Michae1Park/Batteryless_Implant/README.md

# SeniorDesign
Our Senior Design Project to build a medical implant for Rats

Contributor:
Michael Park,
Corey Cormier,
Albert Marzullo,
Makeila Sorensen,
Anish Vaghasia,
Thomas Ermis
