Michae1Park/Batteryless_Implant/Papers/Systems_Design_backup.odt

1.0 INTRODUCTION

This system design report details the design and implementation of an embedded implant system for lab animals in a research environment. This system will aid in research environments that use lab animals for testing purposes. In normal lab environments it can be difficult for researchers to take precise multiple measurements of lab animals for data acquisition purposes. Therefore a system that will allow the researcher to make quick, easy measurements from lab animals and efficiently process the data would provide a great benefit to many research companies. This design was created after careful analysis of client needs, thorough research, and consideration of final deliverables. The proposed design calls for a three subsystem approach made of an implant, a base station, and a web application. The implant will be surgically implanted in the rat and will collect the data. The implant will be wirelessly powered and communicated with by the base station. The base station will in turn collect the data and wirelessly transfer the data to a web app that will collect and display information to the user. Our design will meet the specific needs of our client as defined below while also leaving room for flexibility for future applications.

In order to fully summarize the proposed design, the paper will first outline the problem and the needs of the client. Then the necessary performance

2.0 DESIGN PROJECT BACKGROUND

2.1 Problem Definition

The methods that scientists currently use to collect data from laboratory rats are highly inefficient. Each time a scientist needs to analyze data from a single rat, he or she has to repeatedly collect blood or urine samples, which is time-consuming and expensive. Therefore, Dr. Valvano needs a data acquisition system that will allow scientists to monitor the data more efficiently and at a lower cost. He requires that we reconstruct and improve upon the design of a three-part system that he and a graduate student, Andrew Wang, have partially implemented. The first component needs to be batteryless and wireless implant that will be embedded into a rat and collect data from sensors. The second component needs to be a base station that will use induction coils to wirelessly power and communicate with the implant. The third component needs to be a user interface that will receive commands from a user, communicate with the base station, and display the collected data. The idea is that a scientist would send a command from the user interface to the base station to power the implant. From there, the implant would collect data and communicate that data back to the base station and to the user interface for the scientist to monitor and analyze.

2.2 Needs Analysis

As the primary stakeholder of our project, Dr. Valvano needs a data acquisition system that allows scientists to monitor data from laboratory rats more efficiently and at a lower cost. In order for our team to design such a system, Dr.Valvano has provided us with a set of requirements.

The following list outlines Dr. Valvano’s needs for the data acquisition system.

- The system needs to consist of an implant, base station, and web application in order to compartmentalize functionality.
- The implant needs to have a long lifespan so that it can be embedded in a rat and not have to be consistently replaced.
- The implant needs to be small enough so that it can be embedded into a rat without affecting how the rat functions.
- The implant needs to be sterile and biocompatible so that it can be embedded into a rat without causing the rat any harm.
- Because of the environmental constraints, the implant needs to be wireless, cannot have a battery, and cannot have bluetooth or wifi modules.
- The base station needs to use induction coils to wirelessly power the implant since the implant needs to be wireless and cannot have a battery.
- The implant needs to flash an LED on and off so that the users know when the implant is powered.
- The implant needs to accurately collect temperature and acceleration data so that the users can monitor and analyze the temperature and acceleration of a rat.
- The implant and the base station need to use induction coils to wirelessly communicate with each other in order to send and receive commands and data.
- The base station and the web application need to wirelessly communicate with each other in order to send and receive commands and data.
- The web application needs to be accessible and scalable in order to maximize user population.
- The web application needs to accept input from a user so that the user can request data from the implant.
- The web application needs to display the data from the implant real-time so that the users can easily monitor and analyze it.
- The web application needs to accurately store the data in a database so that the users can view a historical record of the data.
- The system needs to be secure in order to protect any proprietary information and confidential data.

Design Functionality

2.3 Performance and Environmental Specifications

In order for our design to satisfy Dr. Valvano’s needs, it must function accurately and efficiently independent of varying environmental conditions. The performance specifications optimize the lifespan of the implant, bandwidth between the implant and base station, scalability and security of the web application, and the response time of the entire system. The environment specifications account for the implant having to operate within a rat, the base station requiring a power supply and internet connection, and the web application needing to function on multiple platforms and browsers. Achieving these specifications will allow our system to operate accurately and efficiently under a variety of external settings.

2.3.1 Performance Specifications

In order to be used as intended, the system must adhere to specific performance requirements. First, the implant must be able to last within the rat for an extended period of time. Second, the induction coils of the base station must deliver enough power to the implant to be able to drive microprocessor and the sensors on the implant. The exact power required will depend on the sensors we use to take the measurements. Third, the implant will need to be able to take different measurements and communicate them to the base station in an appropriate amount of time. Fourth, these measurements must be accurate to a certain degree to ensure the usefulness of the data. Finally, the base station and implant must communicate in accordance to applicable communication standards. Table 5 describes the performance specifications in more detail.

Table X. Performance Specifications

Subsystem | Name | Description | Specification
Implant | Minimum Lifespan | Minimum length of time that the implant must operate for from the time of implantation | 6 months
Implant and Base Station | Minimum Bandwidth | Minimum speed at which the implant and base station must transfer bits of data to and from each other | 1 Hz
Web Application | Scalability | Level of scalability offered by the web application | Horizontal, Vertical
Web Application | Security | Level of security protecting the web application | Authentication, Authorization, Integrity, Encryption, Auditing
System | Maximum Response Time | Maximum length of time that the system must respond to the user within | 1 minute

2.3.2 Environmental Specifications

The system is intended to be used in a laboratory or some other controlled environment, so there are no harsh or unusual conditions that the base station and user interface must operate under. However, because the implant will be embedded in a live rat, there are environmental requirements that our implant must meet. First, the implant must be small enough to fit inside a rat. Second, the device must be able to function correctly before implantation, and therefore at room temperature. Third, it must operate inside the rat, despite fluctuations of the internal temperature of the rat, which can range anywhere from 35.9° to 39.4° Celsius [10]. Fourth, the implant must be unaffected by any internal fluid surrounding it inside of the rat. Finally, the device must be sterile and biocompatible. This means the implant must be free from bacteria or other living microorganisms and the device must not be harmful to living tissue. This will ensure that the implant does not negatively impact the rat’s health. Table 6 describes the environment specifications in more detail.

Table X. Environmental Specifications

Subsystem | Name | Description | Specification
Implant | Maximum Footprint | Maximum area of the implant | 25 cm2
Implant | Sterility | Minimum sterility assurance level for the implant | SAL of 10-6 [X]
Implant | Biocompatibility | Minimum standard of biocompatibility for the implant | ISO 10993 [X]
Implant | Temperature | Range of temperature for the implant to operate in | 15° to 45° C
Base Station | Power | Power source for the base station | Access to power outlets
Base Station and Web Application | Internet | Internet connection for the base station and web application | Access to secure wifi
Web Application | Platforms | Minimum platforms the web application needs to be accessed on | Windows 7, Mac OS X, Linux
Web Application | Browsers | Minimum browsers the web application needs to be accessed on | Chrome 49, FireFox 45, Safari 9, Opera 35, Microsoft Edge 24, Internet Explorer 10

2.4 Deliverables

There are several deliverables that we will provide by the end of the Fall 2016 semester. These project deliverables consist of a prototype of our data acquisition system and the associated documentation. The prototype will be a three-part system consisting of the implant, the base station, and the user interface. The implant will be small and batteryless, and will collect temperature and acceleration data from within a mock rat. The base station will wirelessly power and communicate with the implant and the user interface will display the collected data. The documentation will include both stakeholder and user documentation. The stakeholder documentation will describe our research and our design, and include code, schematic diagrams, circuit board layouts, and design documentation. The user documentation will describe the installation, operation, and maintenance of the system.

Relevant Standards

3.0 SYSTEM DESIGN

The final prototype of the data acquisition system will consist of three subsystems with inputs and outputs to and from the user. The three subsystems consist of an implant, a base station, and a user interface.

The user interface will allow the user to control the system via commands to the base station. These commands will allow the user to initiate data acquisition, view the requested data, and view a history of past data collected.

The base station’s main function is to wirelessly power and communicate with the implant. When powered, the base station will power the implant through a pair of coupled induction coils. ~~drive an alternating current through a transmission coil located on top of the rat’s cage in order to create an alternating magnetic field through the cage. This alternating magnetic field will then create an alternating current on a receiver coil on the implant located inside the rat.~~ ~~Modulation of this magnetic field~~ These coils will also be used to send commands from the base station to the implant.

The implant will then measure the temperature and acceleration of the rat. Next, the implant will relay temperature and acceleration measurements from the rat and the implant’s ID back to the base station through a communication antenna on the implant. This data will then be transmitted to the user through the user interface.

Figure X. System Block Diagram

3.1 Implant Design (too much detail? particularly in spec paragraph)

The implant will collect biomedical data from a laboratory rat in which it is implanted and transmit the data to the base station as shown in Figure 1. As discussed before, the implant needs to collect temperature and acceleration data, to wirelessly communicate with the base station, and be wirelessly powered, sterile, biocompatible and small enough to be implanted in a laboratory rat. Thus, an induction coil, a temperature sensor, and an accelerometer sensor is required. Details of the specifications of the implant will be discussed in the following paragraph.

Table X. Implant Input Specifications

From | Name | Description | Specification
Base Station | Wireless Power | Amount of power transferred within a certain distance | Range 0 to 200 mW 0 to 18 cm Accuracy ± 0.00 mW ± 0.01 cm
Base Station | Data Command | Command to acquire data | See Table X. Data Command Specifications
Sensor | Temperature | Temperature measurement | Range 15° to 45° C Accuracy ± 0.01° C
Sensor | Acceleration | Acceleration measurement | Range ± 2 g Accuracy 0.01 g

Table X. Implant Output Specifications

To | Name | Description | Specification
Base Station | Data | Results from the data acquisition | See Table X. Data Specifications

  1. Implementation
    1. RF430
    2. LIS3DH (accelerometer)

-> state why we picked these components

  2. Pseudo Conclusion
    1. Tie back to how our implementation meets the requirements

3.2 Base Station Design

The base station will primarily serve as a power source for the implant and a “middleman” that connects the implant and the web application. The base station will receive and transmit the data sent from the implant to the web application as shown in Figure 1. As mentioned before, in order for the base station to meet our needs to wirelessly power and communicate with the implant, use of induction coil and access to the Internet. Details of the input and output specifications to meet the requirements will be discussed in the following paragraph.

The base station requires inputs from three different sources: user inputs, web application inputs, and an implant input. These user inputs include power, Internet connection, power command, data command, and data as presented in the table X below. The user inputs include power and Internet connection. First user input is power for the base station which should provide 3.3V and 1A since all of our components require 3.3V voltage and maximum of 1A current in entirety. Second user input is a secure Wifi connection as the base station needs to send and receive commands and data. The inputs from the web application include power command and data command. The power command needs to turn the base station on from standby state, and the data command needs to send the base station to start and stop data collection, which in turn will be sent to the implant. Both commands will simply have one bit binary data to represent, on/standby and start/stop data collection. The input from the implant is the data collected from the implant. The data will be represented in 16 digit sequence of numbers. In the following section, implementation of our base station will be described to address all the specifications addressed.

Table X. Base Station Inputs

From | Name | Description | Specification
User | Power | Power source for the base station | Value 3.3 V 1 A Accuracy ± 0 V ± 0 A
User | Internet | Internet connection for the base station | Secure wifi
Web Application | Power Command | Command to turn on the base station | See Table X. Power Command Specifications
Web Application | Data Command | Command to acquire data | See Table X. Data Command Specifications
Implant | Data | Results from the data acquisition | See Table X. Data Specifications

Table X. Base Station Outputs

To | Name | Description | Specification
Implant | Wireless Power | Amount of power transferred within a certain distance | Range 0 to 200 mW 0 to 18 cm Accuracy ± 0 mW ± 0.01 cm
Implant | Data Command | Command to acquire data | See Table X. Data Command Specifications
Web Application | Data | Results from the data acquisition | See Table X. Data Specifications

The base station will consist of a coil, an NFC/RFID transceiver, a microcontroller, and a Wifi module to control the subsystem, power and communicate with the implant, and transit data to the web app respectively. TRF7970A will be used for the NFC/RFID transceiver because it can directly control the coil to power the implant and receive the data from the implant. MSP430 will be used for the microcontroller due to its low power nature and its compatibility with TRF7970A. The ESP8266 will be used for the Wifi module because it is small, reliable, and cheap. The coil will be interfaced to the TRF7970A which in turn will be interfaced to the MSP430, and separately, ESP8266 will be interfaced to the MSP430. The TRF7970A will communicate with the MSP430 to transmit data using serial synchronous interface (SSI). The ESP8266 will use universal asynchronous receiver/transmitter (UART) to communicate with the MSP430. We will use a wall power and an AC-DC power converter to power the base station. The AC-DC power converter will output 3.3V and 1A, and TRF7970A, MSP430, and ESP8266 will be connected respectively. As described, our implementation of the base station using the components TRF7970A, ESP8266, and MSP430 will fulfill the requirements to wirelessly power and communicate with the implant and to transmit data received from the implant all the way to the web application.

3.3 Web Application Design

The third subsystem of the Data Acquisition System is a web application. In order for the web application to operate as efficiently as possible, it needs to be accessible and scalable. In addition, it needs to receive commands from the user, send commands to and receive data from the base station, display the data back to the user, and store the data in a database. Please refer to Tables X and X below for a detailed description of the web application’s inputs and outputs. Finally, because the data handled by the web application might be confidential, it is important that the web application is secure.

Table X. Web Application Input Specifications

From | Input | Description | Specification
User | Authentication | Credentials to access to the web application | See Table X. Authentication Specifications
User | Power Command | Command to turn on the base station | See Table X. Power Command Specifications
User | Data Command | Command to acquire data | See Table X. Data Command Specifications
Base Station | Data | Results from the data acquisition | See Table X. Data Specifications

Table X. Web Application Output Specifications

To | Output | Description | Specification
Base Station | Power Command | Command to turn on the base station | See Table X. Power Command Specifications
Base Station | Data Command | Command to acquire data | See Table X. Data Command Specifications
User | Data | Results from the data acquisition | See Table X. Data Specifications

The web application will be built using IBM Bluemix, a cloud platform for developing accessible and scalable web and mobile applications. In order to secure the web application, we will use the Single Sign On service that is provided by IBM Bluemix. This service requires users who are attempting to access the web application to authenticate themselves. As depicted in Figure X below, we will use the IBM Watson Internet of Things Platform (WIoT) service in order to interface the web application with the base station. As long as both the base station and the web application are connected to the internet, they can use the WIoT service to communicate with each other. In other words, the web application will be able to send commands to the base station and the base station will be able to send data back to the web application. Upon receiving data, the web application will display the data on a web page and store the data in a database. In order to store the data in a database, we will use the Cloudant NoSQL Database service, which is also provided by IBM Bluemix.

Figure X. Web Application Block Diagram

<FIGURE>

4.0 USER INTERFACE DESIGN

The user interface for the Data Acquisition System consists of a web page on the web application and an LED on the implant. Initially, the implant will be off and the base station will be on standby. Through the web page, the user will send a command to the base station to switch it from standby mode to on. Once the base station is on, the user will send a command to the base station to acquire data from the implant. From there, the base station will power the implant. In order to indicate the the implant is on, an LED on the implant will flash on and off. Now that the implant has power, the base station will send a command to the implant to acquire data from the sensors. Once the implant collects temperature and acceleration data, the implant will send the data back to the base station. From there, the base station will send the data back to the web application. Once the web application receives the data, it will store the data into a database as well as display the data on a web page for the user to monitor and analyze.

5.0 RISK REDUCTION

We have taken steps to reduce the risks that would prevent us from finishing the project on time. Starting with a preliminary system design, we researched different parts we can use that will simplify our design while adding the additional functionality that was required. We ordered evaluation modules for these parts and began experimenting with them. These experiments showed us that these parts were capable of transmitting power and data through induction coils. We also researched alternate coil topologies we can try if our first designs do not meet our specifications. Additionally, our group met with the graduate student on whose project we based our preliminary design. He told us about all of the snags he ran into and how we could avoid them as well as

- Ordered several eval boards for processors we are considering
  - RF communication is possible
  - Power requirements are met
  - Checked communication and RF ability of processors
  - Obtained sample code for use of induction coils
- Talked to a grad student our project is based on
  - Learned risks they faced
  - Optimal coil designs
  - Coil topology
- Research
  - Possible alternate design decisions

6.0 PROTOTYPE COST

The total cost for the prototype will be $329.26, as shown in Table 1. We will purchase a MSP-EXP430FR5739 microcontroller from TI for $35 to process data collected from the implant. In addition, we will use a ESP8266 wifi module from SparkFun Electronics for $6.95 to interface our base station with our web application user interface. As the final component of our base station, we will use the TRF7970AEVM from TI for $99 to power and communicate with our implant. We will use a TI manufactured RF430FRL152HEVM $19.90 low-power processor in our implant to collect sensor data and communicate with our base station. We will order a LIS3DH accelerometer sensor to integrate with our implant microcontroller for $3.78. Finally, we will use a pre-owned variety of 50 resistors and capacitors, valued at $5.00, in our circuit design. All of the above TI components were generously donated for our project. We have at least one duplicate component for every part as a backup.

Table X. Budget Proposal

7.0 TEST PLAN

Our design project will require a large amount of testing as we will go through many iterations of designs to perfect the coil topology and get the performance to our specifications. We will need an organized plan to ensure that we are efficient in testing.

7.1 Coil Testing

Having a coil design that meets our requirements for data and power transfer is the most important part of our project. It will probably have to go through many design revisions, so it is important to have a plan to test each coil design. We will create a testing environment consisting of our base station coil connected to a 13.56MHz function generator. This frequency matches the normal operating frequency. The implant coil designs will be placed 7 inches below the testing coil one at a time and be attached to a DC electronic load set to the current requirement of our implant. The coil should be able to maintain at least 1.45V under the load (the minimum supply voltage of the RF430) which will be measured by an oscilloscope across the coil leads. This voltage will be plotted for various positions underneath the base station coil. This testing will ensure the coil can be used for the implant and further testing.

7.2 Subsystem Testing

The three main subsystems of our project will be tested independently to ensure they are working before we put them all together. The implant will be tested twice by seeing if code running on it can blink an off-board LED by controlling a MOSFET. In the first test, the implant will be powered by a bench power supply. In the second test, it will be powered wirelessly through the testing coil mentioned in the previous section. These will allow us to see both if the code itself works and if the coil is sufficient for powering the implant.

For the base station we will first connect an oscilloscope to the coil and see if the signal present is 13.56MHz and that the power in the antenna is close to 200mW (the max power of the TRF7970). If the power output is low, the filter and coil designs will need to be modified. Next we will test its Wi-Fi capability by sending blocks of dummy data to a server. The web application can be tested by reading this dummy data and displaying it.

- Implant
  - Data Acquisition
    - Testing port on implant consisting of mosfet and connector
    - Wire LED to port using external power supply, have RF430 blink LED
  - Power
    - Implant connected to coil test system and to check if it can be powered
- Base Station
  - Power the Coil
    - Connect base station to coil and see if the part works with our coil (13.56MHz)
  - Test wifi module
    - Send dummy data to server
- Web Application
  - Receive dummy data from server
  - Display data

7.3 System Testing

Once all the subsystems are put together, our group needs to make sure that they all communicate with each other correctly. Using the web application, we will request hundreds of data samples and make sure that they all match what the implant gathered. To do so, we will attach an oscilloscope to one of the ports on the implant that we will make output the data value for easy comparison. If the value from the implant and the value displayed on the web application are different, or if no data is received, there is probably an error in the base station and debugging would begin there.

8.0 PROJECT SCHEDULE

As seen in Appendix X, our Gantt chart outlines a schedule to build a prototype two weeks before Open House in November 2016. In order to build, debug, and test our prototype, we have divided

9.0 CONCLUSION
