Michae1Park/Batteryless_Implant/Papers/Systems_Design_backup2(almost done).odt

1.0 INTRODUCTION

This system design report details the design, implementation, and analysis of a surgically implanted data acquisition system for lab animals in a research environment. This system will aid in research environments that use lab animals for testing purposes. In normal lab environments it can be difficult for researchers to take precise multiple measurements of lab animals for data acquisition purposes. Therefore a system that will allow the researcher to make quick, easy measurements from lab animals and efficiently process the data would provide a great benefit to many research companies. This design was created to meet the client’s needs, as well as the performance and environmental specifications. The proposed design calls for a three subsystem approach made of an implant, a base station, and a web application. The implant will be surgically implanted in the rat and will collect the data. The implant will be wirelessly powered and communicated with by the base station. The base station will in turn collect the data and wirelessly transfer the data to a web app that will collect and display information to the user. Our design will meet the specific needs of our client as defined below while also leaving room for flexibility for future applications.

The project was shaped by the varying needs of the client and the operating conditions it will operating under. Additionally, steps like risk analysis and test suite creation were also taken to improve the implementation of the project. The client, Dr. Valvano, originated the project and requires a more efficient and cost effective solution for lab environments. Due to part of the system being inside an animal, there will be certain environmental and performance specifications that will also shape the operation of the system. Next a thorough description of the proposed three-part design will show how it meets the needs of being more efficient and operating inside a rat. After the risks of lacking parts and time are thoroughly considered and planned for, the cost of the project will be determined. Finally, to determine the validity of the subsystems as well as the system as a whole, a suite of tests that break apart for each of the design’s three parts will be proposed. This will not only serve as subsystem validation but also checkpoints for the project itself. To conclude, an outline of the Fall 2016 work schedule will show how this this design will be implemented in time for the ECE open house.

2.0 DESIGN PROJECT BACKGROUND

In order to make the collection of data from laboratory rats more efficient and less expensive, Dr. Valvano needs a data acquisition system. Essentially, the data acquisition system needs to collect data from the rat and display the data back to the user. The problem, Dr. Valvano’s needs, the key performance and environmental specifications, and the final deliverables are described in more detail in the following subsections.

2.1 Problem Definition

The methods that scientists currently use to collect data from laboratory rats are highly inefficient. Each time that a scientist needs to analyze data from a single rat, he or she has to repeatedly collect blood or urine samples, which is both time-consuming and expensive. Therefore, our team is tasked with designing a data acquisition system that will allow scientists to monitor data from laboratory rats more efficiently and at a lower cost.

2.2 Needs Analysis

As the primary stakeholder of our project, Dr. Valvano needs a data acquisition system that will allow scientists to analyze data from laboratory rats more efficiently and less expensively. He requests that the data acquisition system consists of three subsystems: an implant, a base station, and a web application. These three subsystems need to function together to collect data from a rat and display the data back to the user. In order for our team to successfully design such a system, Dr.Valvano has provided us with a detailed set of requirements.

The following list outlines Dr. Valvano’s needs for the data acquisition system.

- The system needs to consist of an implant, a base station, and a web application in order to compartmentalize functionality.
- The implant needs to accurately collect temperature and acceleration data so that the users can monitor and analyze the temperature and acceleration of a rat.
- The implant needs to be embedded into a rat. Therefore, it needs to be small, batteryless, and wireless so that it doesn’t affect how the rat functions. In addition, it needs to be sterile and compatible so that it doesn’t adversely affect the rat’s health. Finally, it needs to have a long lifespan so that it doesn’t need to be constantly replaced.
- The base station needs to power and communicate with the implant. Because the implant needs to be batteryless and wireless, the base station needs to use induction coils to wirelessly power the implant. In addition, because the implant cannot contain bluetooth or wifi modules because of their size, the base station needs to use induction coils to also wirelessly communicate with the implant.
- The base station needs to communicate with the web application. Because the size of the base station is not restricted and because it is preferable for the base station to be wireless, the base station needs to use wifi to communicate with the web application.
- The web application needs to be accessible, scalable, and interactive. More specifically, the web application needs to allow users to request data from the implant. In addition, the web application needs store the data in a database so that the user can view a historical record of the data. Finally, the web application needs to display the data real-time so that the user can easily monitor and analyze the data.
- The data acquisition system needs to be secure in order to protect any proprietary information and confidential data.

2.3 Performance and Environmental Specifications

In order for our design to satisfy Dr. Valvano’s needs, the data acquisition system must function accurately and efficiently independent of varying environmental conditions. By adhering to certain performance and environmental specifications, we can ensure that our system operates correctly under a variety of external settings. These performance and environmental specifications are described in more detail below.

2.3.1 Performance Specifications

As a piece of equipment that will be used in research laboratories, it is important that our system adheres to certain performance specifications. For example, because the implant will be embedded into a rat and cannot be easily replaced, the implant must be able to operate for a certain period of time. Additionally, in order to guarantee that data is communicated efficiently, the implant and the base station must transmit bits of data at a certain bandwidth. Third, the web application needs to be scalable so that it can be accessed by many users at once. Furthermore, because the data that the web application will be handling might be confidential, it is important the web application is secure. Finally, the the system must respond to the user within a certain timeframe. Table X describes these performance specifications in more detail.

Table X. Performance Specifications

Subsystem | Name | Description | Specification
Implant | Minimum Lifespan | Minimum length of time that the implant must operate for from the time of implantation | 6 months
Implant and Base Station | Minimum Bandwidth | Minimum speed at which the implant and base station must transmit bits of data to and from each other | 1 Hz
Web Application | Scalability | Level of scalability offered by the web application | Horizontal, Vertical
Web Application | Security | Level of security protecting the web application | Authentication, Authorization, Integrity, Encryption, Auditing
System | Maximum Response Time | Maximum length of time that the system must respond to the user within | 1 minute

2.3.2 Environmental Specifications

In addition to performance specifications, it is also important that our system adheres to certain environmental specifications. Because the implant will operate within a living rat, the implant is subject to the most environmental constraints. For example, because the implant needs to be small enough to be embedded into a rat, the implant is restricted to a certain size. In addition, the implant needs to be sterile and biocompatible so that it doesn’t adversely affect the rat’s health. Third, the implant needs to be able to function properly at room temperature as well as at the temperatures typical of a rat. In order for the base station to operate, the base station needs to have access to both a power outlet and secure wifi so that it can transfer power to the implant and communicate data between the implant and the web application. Finally, the web application needs to run on a wide variety of platforms and browsers in order to accommodate the user population. Table X describes the environmental specifications in more detail.

Table X. Environmental Specifications

Subsystem | Name | Description | Specification
Implant | Maximum Footprint | Maximum area of the implant | 25 cm2
Implant | Sterility | Minimum sterility assurance level for the implant | SAL of 10-6 [X]
Implant | Biocompatibility | Minimum standard of biocompatibility for the implant | ISO 10993 [X]
Implant | Temperature | Range of temperature for the implant to operate in | 0° to 45° C
Base Station | Power | Power supply for the base station | Access to power supply
Base Station and Web Application | Internet | Internet connection for the base station and web application | Access to internet connection
Web Application | Platforms | Minimum platforms the web application needs to be accessed on | Windows 7, Mac OS X, Linux
Web Application | Browsers | Minimum browsers the web application needs to be accessed on | Chrome 49, FireFox 45, Safari 9, Opera 35, Microsoft Edge 24, Internet Explorer 10

2.4 Deliverables

The deliverables for our project include a prototype of the data acquisition system and the associated documentation. The prototype of the data acquisition system will consist of three subsystems. The first subsystem will be a small, batteryless and wireless implant that collects temperature and acceleration data from sensors. The second subsystem will be a base station that uses induction coils to wirelessly power and communicate with the implant and wifi to wirelessly communicate with the web application. The third subsystem will be a web application that allows the user to request data from the implant, stores the data in a database, and displays the data back to the user. The documentation will include documentation for both our stakeholder, Dr. Valvano, and for the typical user of our data acquisition system. For Dr. Valvano, we will provide block diagrams, pcb layouts, and circuit schematics for both the implant and the base station. In addition, we will provide the code that runs on the both the implant and the base station. Furthermore, we will provide full access to the web application and its code. For the user, we will provide documentation containing instructions for installing, operating, and maintaining the data acquisition system. We plan to deliver the prototype and the associated documentation by Monday, December 5th, 2016, the last day of the Fall 2016 semester.

Relevant Standards

3.0 SYSTEM DESIGN

The final prototype of the data acquisition system is comprised of three subsystems that will connect the user to data from a laboratory rat. As illustrated in Figure X below, the three subsystems are an implant, a base station, and a web application. The web application will require the user to authenticate himself before he can use it. Once authenticated, the user will be able to control and interact with the data acquisition system. From the web application, the user will use wifi to send power and data commands to the base station. The base station will then use induction coils to wirelessly power and relay the data commands to the implant. Once powered, the implant will use a temperature sensor and an accelerometer to measure the temperature and acceleration of the rat. From there, the implant will use the induction coils to relay the data back to the base station. The base station will then use wifi to transfer the data back to the web application. From the web application, the user can view the collected data.

Figure X. System Block Diagram

In the following subsections, we breakdown each subsystem of the data acquisition system. First, we describe the functionality of the subsystem. Next, we outline the input and output specifications. Finally, we discuss how we plan to implement each subsystem.

3.1 Implant Design

The implant will collect temperature and acceleration data from a laboratory rat and send the collected data to the base station as shown in Figure X above (block diagram). As mentioned earlier, in order for the implant to be powered wirelessly and collect the measurement data, it must make use of an induction coil and sensors. Details of the specifications of the inputs and the outputs will be discussed in the following paragraph.

The implant will take in inputs from the base station and the sensors. The inputs from the base station will be wireless power and a command to start acquiring data (data command). The sensor inputs will be temperature and acceleration measurements. As specified in Table X below, the range of the input power to the implant will be from 0 to 200mW, and the range of the distance between the implant and the base station will be from 0 to 18cm with a maximum range error of 0.01 cm. The data command will be represented as a 1 bit binary number which will be set to 0 by default. When the data command issues a 1, the implant will start collecting data until a 0 is issued. The temperature measured will be within a range of 0° and 45° C with a maximum error of 0.01° C. The acceleration measured will to be from -2g to + 2g with the accuracy of a 0.01g. The implant will have one output of the measurement data to the base station. As specified in Table X below, the collected data to be sent to the base station needs to be a 16 bit binary dataset.

Table X. Implant Input Specifications

From | Name | Description | Specification
Base Station | Wireless Power | Amount of power transferred within a certain distance | Range 0 to 200 mW 0 to 18 cm Accuracy ± 0.00 mW ± 0.01 cm
Base Station | Data Command | Command to acquire data | See Table X. Data Command Specifications in Appendix X
Sensor | Temperature | Temperature measurement | Range 0° to 45° C Accuracy ± 0.01° C
Sensor | Acceleration | Acceleration measurement | Range ± 2 g Accuracy 0.01 g

Table X. Implant Output Specifications

To | Name | Description | Specification
Base Station | Data | Results from the data acquisition | See Table X. Data Specifications in Appendix X

To meet all our needs, the implant will be implemented by using a microcontroller, an accelerometer, and a coil. As presented in Figure X below (implant diagram), the microcontroller will be powered by the the coil that wirelessly receives power from the base station, and in turn power the temperature sensor and the accelerometer.When the coil receives a raw signal containing the data command, it will transfer the data to the microcontroller which in turn will decode and understand the command. Once the microcontroller understands the data command, it will start sampling data from the accelerometer and a temperature sensor using a built-in analog to digital converter (ADC). The collected data will be represented in raw ADC data which in turn will be sent to the base station through the coil.

To meet all the requirements and specifications mentioned in the previously, we chose the components of the implant accordingly. As shown in Figure X below (implant diagram), we decided to use RF430 for the microcontroller. Since the RF430 contains a built-in NFC/RFID transceiver and a temperature sensor, it will alleviate the burden of externally interfacing them. Thus the RF430 will allow us to interface the coil without much external circuitry. The RF430 is also an extremely low power microcontroller which fulfills our need for a low power implant perfectly. The LIS3DH will be used for our accelerometer due to it’s low power requirements meeting the 200 mW maximum of the board. Likewise our implementation of the implant using the RF430 and LIS3DH will satisfy our needs for it to be wirelessly powered, acquire and transmit data, and consume very little power.

Figure X. Implant Block Diagram

3.2 Base Station Design

The base station will primarily serve as a power source for the implant and a “middleman” that connects the implant and the web application. The base station will receive and relay the data sent from the implant to the web application as shown in Figure X (block diagram) above. As mentioned before, in order for the base station to meet our needs to wirelessly power and communicate with the implant, the base station must use induction coils and have access to the Internet. Details of the input and output specifications to meet the requirements will be discussed in the following paragraph.

The base station will have four sources of inputs: the implant, the web application, a power supply, and an internet router. First, as shown in Figure X (block diagram) above, measurement data input will come from the implant. Second, power command and data command inputs will come from the web application. Finally, power and an Internet connection will come from a 3.3V power supply and an internet router. As specified in Table X below, the collected data sent from the implant will be represented in a 16 bit binary format. The power command and the data command will be represented in 1 bit binary number, both of which will be 0 by default. When the power command issues a 1, the base station will turn on from its standby state. When the data command issues a 1, the implant will start collecting data until a 0 is issued. The power coming from the wall will be converted into a 3.3V, and the Internet connection will be established through a secure Wifi provided by the router.

The base station will output to two modules: the implant and the web application. First, as shown in Figure X (block diagram) above, the base station will output wireless power and a command to acquire data to the implant. Second, the base station will output the data acquisition results to the web application. As specified in Table X below, the power and the distance range between the base station and the implant is the same as input specifications of the implant. The command to acquire data sent from the web application, an input to the base station mentioned in the previous paragraph, simply will be passed on to the implant as an output from the base station. Similarly, the collected data sent from the implant will be passed on to the web application.

Table X. Base Station Inputs

From | Name | Description | Specification
Power Supply | Power | Power supply for the base station | Value 3.3 V 1 A Accuracy ± 0 V ± 0 A
Internet Router | Wifi | Wifi for the base station | Secure wifi
Web Application | Power Command | Command to turn on the base station | See Table X. Power Command Specifications in Appendix X
Web Application | Data Command | Command to acquire data | See Table X. Data Command Specifications in Appendix X
Implant | Data | Results from the data acquisition | See Table X. Data Specifications in Appendix X

Table X. Base Station Outputs

To | Name | Description | Specification
Implant | Wireless Power | Amount of power transferred within a certain distance | Range 0 to 200 mW 0 to 18 cm Accuracy ± 0 mW ± 0.01 cm
Implant | Data Command | Command to acquire data | See Table X. Data Command Specifications in Appendix X
Web Application | Data | Results from the data acquisition | See Table X. Data Specifications in Appendix X

In order to meet all of our needs mentioned in the needs analysis section, the base station will be implemented using a microcontroller, a NFC/RFID transceiver, a Wifi module, a coil, and an AC to DC power converter. As shown in Figure X below (base station diagram), the microcontroller, the NFC/RFID transceiver, and the Wifi module, will all be powered by the power output of the AC to DC power converter, but the coil will be powered by the NFC/RFID transceiver. For the collected data from the implant to reach the web application, it will go through the coil, NFC/RFID transceiver, the microcontroller, and the Wifi module in the exact order. The coil will receive a raw signal that contains the data collected from the implant, which in turn will be converted into a binary data by the NFC/RFID transceiver. Next, the NFC/RFID transceiver will send the binary data the microcontroller using a Serial Synchronous Interface (SSI). Once the microcontroller receives the binary data, it will decode the data, pack it into JavaScript Object Notation (JSON), and transmit it to the Wifi module using a Universal Asynchronous Receiver/Transmitter (UART). Once the Wifi module receives the data packed into JSON, it will transmit it to the web application through a secure Wifi. For the commands issued from the web application to reach the implant, it will go through the modules of the base station in the order of the Wifi module, the microcontroller, the NFC/RFID transceiver, and the coil. Once the Wifi module receives a command data in JSON, it transmits the data to the microcontroller using the UART. The microcontroller in turn will decode and reformat the data into a binary data and transmit it to the NFC/RFID transceiver. The NFC/RFID transceiver will at last decode the binary and send the command signal to the implant through the coil.

We chose the components for the modules of our base station to specifically meet all the requirements and the specifications mentioned previously. As shown in Figure X below (base station diagram), first, we will use TRF7970A for the NFC/RFID transceiver. The component will allow us to directly power and control the coil to communicate with the implant. Secondly, we will use MSP430 for the microcontroller due to its low power nature and its compatibility with the TRF7970A. Lastly, we will use ESP8266 for the Wifi module because it is small, cheap, and reliable. The ESP8266 will allow us to interface the base station with the web application in reliable and cost-efficient manner. Likewise, our implementation of the base station using the TRF7970A, the MSP430, and the ESP8266 will fulfill the requirements to wirelessly power and communicate with the implant and wirelessly communicate with the web application.

Figure X. Base Station Block Diagram

3.3 Web Application Design

The third subsystem of the data acquisition system is a web application. The web application will allow the user to control and interact with the data acquisition system. For example, the user will be able to start and stop the process of collecting data from the laboratory rat. In addition, the user will be able to view the current data and a historical record of the data.

As depicted in Figure X below, the web application will receive inputs from an internet router and the user and send outputs to the base station and the user. The internet router will provide the web application with secure wifi so that it can communicate with its server and the base station. In order for the user to access the web application, he will have to authenticate himself. Once authenticated, the user can send power and data commands to the base station. The power command will switch the base station from standby mode to on, while the data command will tell the base station to start the process of collecting data. Once the base station has received the data, the base station will send the data back to the web application. The web application will then output this data to the user. Tables X and X describe the input and output specifications of the web application in more detail.

Figure X. Web Application Block Diagram

Table X. Web Application Input Specifications

From | Input | Description | Specification
Internet Router | Wifi | Wifi for the web application | Secure wifi
User | Authentication | Credentials to access to the web application | See Table X. Authentication Specifications in Appendix X
User | Power Command | Command to turn on the base station | See Table X. Power Command Specifications in Appendix X
User | Data Command | Command to acquire data | See Table X. Data Command Specifications in Appendix X
Base Station | Data | Results from the data acquisition | See Table X. Data Specifications in Appendix X

Table X. Web Application Output Specifications

To | Output | Description | Specification
Base Station | Power Command | Command to turn on the base station | See Table X. Power Command Specifications in Appendix X
Base Station | Data Command | Command to acquire data | See Table X. Data Command Specifications in Appendix X
User | Data | Results from the data acquisition | See Table X. Data Specifications in Appendix X

The web application will be built using IBM Bluemix, a cloud platform for developing accessible and scalable web and mobile applications. In order to secure the web application, we will use the Single Sign On service that is provided by IBM Bluemix. This service requires users to authenticate themselves before they can access the web application. As depicted in Figure X above, we will use the IBM Watson Internet of Things Platform (WIoT) service to interface the web application with the base station. As long as both the base station and the web application are connected to wifi, they can use the WIoT service to communicate with each other. In other words, the web application will be able to send commands to the base station and the base station will be able to send data back to the web application. Upon receiving data, the web application will store the data in a database. In order to store the data in a database, we will use the Cloudant NoSQL Database service, which is also provided by IBM Bluemix. Finally, the web application will display the data to the user so that it can be monitored and analyzed.

4.0 USER INTERFACE DESIGN

The user interface includes the initial setup that is required by the data acquisition system as well as a web page on the web application. Initially, the user will embed the implant into a laboratory rat and place the base station just outside of and adjacent to the rat cage. As illustrated in Figure X below, once the implant and the base station are set up, the user will interact with the data acquisition system through a web page on the web application.

At first, the implant will be off and the base station will be on standby. On the web page, the user can send a power command from the web application to the base station in order to switch the base station from standby mode to on. Once the base station is on, the user can send a data command from the web application to the base station in order to acquire data from the implant. When the base station receives the data command, it will wirelessly power the implant. With the implant powered, the base station will send a command to the implant to acquire data from the temperature sensor and accelerometer. Once the implant collects the temperature and acceleration data, the implant will send the data back to the base station. From there, the base station will send the data back to the web application. When the web application receives the data, it will store the data into a database as well as display the data on a web page. The the users can then use the web page to monitor and analyze the data that was collected from the rat.

Figure X. User Interface Diagram

5.0 RISK REDUCTION

In order to ensure that we finish our project on time, we have taken preventative measures to reduce the risks of our project. ~~We have taken steps to reduce the risks that would prevent us from finishing the project on time.~~ During the preliminary system design, we researched several different parts we could use to simplify our design while maintaining the functionality of the project. We ordered evaluation modules for some of these parts and began experimenting with them. These experiments showed us that these parts were capable of transmitting power and data through induction coils. We also researched alternate coil topologies we could try if our first designs do not meet our specifications. Additionally, our group met with the graduate student on whose project we based our preliminary design. He told us about all of the snags he ran into and how we could avoid them.

6.0 PROTOTYPE COST

With the exception of the accelerometer, all of the materials will be provided by our faculty sponsor. However, the total market value for all the materials of our prototype is $444.96, as shown in Table X. We will use a MSP-EXP430FR5739 microcontroller, valued at $35 [1], to process data collected from the implant. To flash program and debug this microcontroller, we will use a MSP-FET430UIF debugging interface: which is valued at $115.00 [2]. In addition, we will use a ESP8266 wifi module from SparkFun Electronics, valued at $6.95 [3], to interface our base station with our web application user interface. As the final component of our base station, we will integrate the TRF7970AEVM from TI, valued at $99 [4], to power and communicate with our implant. We will use a TI manufactured RF430FRL152HEVM, valued at $19.90 [5], low-power processor in our implant to collect sensor data and communicate with our base station. We will also order two LIS3DH accelerometer sensors, valued at $3.26 [6], to integrate with our implant microcontroller. We will use a pre-owned variety of 50 resistors and capacitors, valued at $8.00 [7], in our PCB implant circuit design. To reduce the risk for project delays, we will have at least one duplicate component for every part, with the exception of the programmer, on our list.

7.0 TEST PLAN

Our design project will require a large amount of testing as we will go through many iterations of designs to perfect the coil topology and get the performance to meet our specifications. We will need an organized plan to ensure that we are efficient in testing. The three main phases of testing will be, in order: testing the coil designs, testing each subsystem, and testing the whole system.

7.1 Coil Testing

Having a coil design that meets our requirements for data and power transfer is the most important part of our project. It will probably have to go through many design revisions, so it is important to have a plan to test each coil design. We will create a testing environment consisting of our base station coil connected to a 13.56MHz function generator. This frequency matches the normal operating frequency. The implant coil designs will be placed 7 inches below the testing coil one at a time. To simulate being inside a rat, this coil will be covered by a material that will be determined later. We will research to find a material that absorbs EM waves similarly to rat skin. The coil will be attached to a DC electronic load set to the current requirement of our implant, and it should be able to maintain at least 1.45V under the load (the minimum supply voltage of the RF430) which will be measured by an oscilloscope across the coil leads. This voltage will be plotted for various positions underneath the base station coil. This testing will ensure the coil can be used for the implant and further testing.

7.2 Subsystem Testing

The three main subsystems of our project will be tested independently to ensure they are working before we put them all together. The implant will be tested twice by seeing if code running on it can blink an off-board LED by controlling a MOSFET. In the first test, the implant will be powered by a bench power supply. In the second test, it will be powered wirelessly through the testing coil mentioned in the previous section. These will allow us to see both if the code itself works and if the coil is sufficient for powering the implant.

For the base station we will first connect an oscilloscope to the coil and see if the signal present is 13.56MHz and that the power in the antenna is close to 200mW (the max power of the TRF7970). If the power output is low, the filter and coil designs will need to be modified. Next we will test its Wi-Fi capability by sending blocks of dummy data to a server. The web application will be tested by reading this dummy data and displaying it.

7.3 System Testing

Once all the subsystems are put together, our group needs to make sure that they all communicate with each other correctly. Using the web application, we will request hundreds of data samples and make sure that they all match what the implant gathered. To do so, we will attach an oscilloscope to one of the ports on the implant that we will make output the data value for easy comparison. If the value from the implant and the value displayed on the web application are different, or if no data is received, there is probably an error in the base station and debugging would begin there.

8.0 PROJECT SCHEDULE

As seen in Appendix X, our Gantt chart outlines a schedule to build a prototype in the 13 weeks before Open House in November 2016. To build, integrate and test our prototype, we have organized our activity around seven key milestones. First, we will dedicate 20 man hours during the first week in September to finalizing our design for our implant and base station coils. We will then allocate 120 man hours to complete and test the prototype of our base station by September 23th. On September 30th, we will finish soldering and testing our prototype implant PCB, as well as designing the protocol we will use to communicate between the implant and base station. We estimate this will take 50 man hours. Finally, we will dedicate 200 man hours to interface our implant to the base station and our base station to the web application on November 9th. This will be the final phase of our prototype’s development, so we are accounting for any unexpected delays by allocating double the amount of time we expect to finish this part. We will dedicate 50 man hours the two weeks prior to open house to test our completed system.

9.0 CONCLUSION

This report has outlined the design and implementation of an implantable data acquisition system for research lab environments. The design problem called for some very specific needs the team would need to meet due to the intended device’s operating environment. Part of the system would be surgically imbedded inside a lab animal and therefore the system would not be able to contain a battery. So one of the major design challenges is that the system needs to be able to wirelessly send power and information. The client specifically prefered this to be done with inductor coils. The system also will be in use primarily by researchers in a lab. Due to this, the system would need to be able to be simple, and quick to use.

The team created their proposed solution to fit the needs of the design problem. The proposed design consists of a three part system: the implant, the base station, and the web application. The implant will be small enough to fit inside lab animals and will have one onboard and one offboard sensor to collect the data. The implant and the base station will have inductor coils attached to wirelessly send power and data between the two subsystems. The base station would then send the data to a web application where it can be viewed by a user. The web application would provide a layer of abstraction between the operation of the system and the use.

To conclude, the proposed system was designed to meet the needs of the clients. In order to reduce the risks of waiting for parts and running into issues with the design, parts have been ordered early and the team has already entered into discussions with a grad student who implemented what this proposed design is based on. Costs have also been analyzed for each subsystem and a total estimate comes just under $350. However, by taking advantage of free parts and university company connections, the cost of the prototype itself will be much much lower. Additionally, testing for the design has been broken down into its subsystems. Testing each subsystem separately will ensure validity while also serving as checkpoints for the implementation stages. Finally a fall semester implementation schedule for the project has been been outlined and attached in the appendix. Now that we have finished the initial design stage of the project, we will be ordering more parts and starting with the implementation of the implant subsystem. The Fall 2016 semester will be dedicated to building the proposed design.

APPENDIX X- BILL OF MATERIALS

Table X: Bill of Materials

REFERENCES FOR APPENDIX X

[1] “MSP-EXP430FR5739 Experimenter Board.” [Online]. Available : http://www.ti.com/tool/msp-exp430fr5739

[2] “MSP430 USB Debugging Interface,” [Online]. Available: http://www.ti.com/tool/msp-fet430uif

[3] “WiFi Module - ESP8266.” [Online]. Available: https://www.sparkfun.com/products/13678

[4] “NFC Transceiver Evaluation Module.” [Online]. Available: http://www.ti.com/tool/trf7970aevm

[5] “NFC ISO 15693 Sensor Transponder Evaluation Module.” [Online]. Available: http://www.ti.com/tool/rf430frl152hevm

[6] “LIS3DHTR,” [Online]. Available: http://www.digikey.com/product-detail/en/stmicroelectronics/lis3dhtr/497-10613-1-nd/2334355?enterprise=44

[7] “Electronic Goldmine.” [Online]. Available: http://www.goldmine-elec-products.com/default.asp
