Michae1Park/Batteryless_Implant/Others/TRF7970A EVM Schematics and Parts List (BOM)/TRF797x_EVM_Rev A1_Schematic.pdf

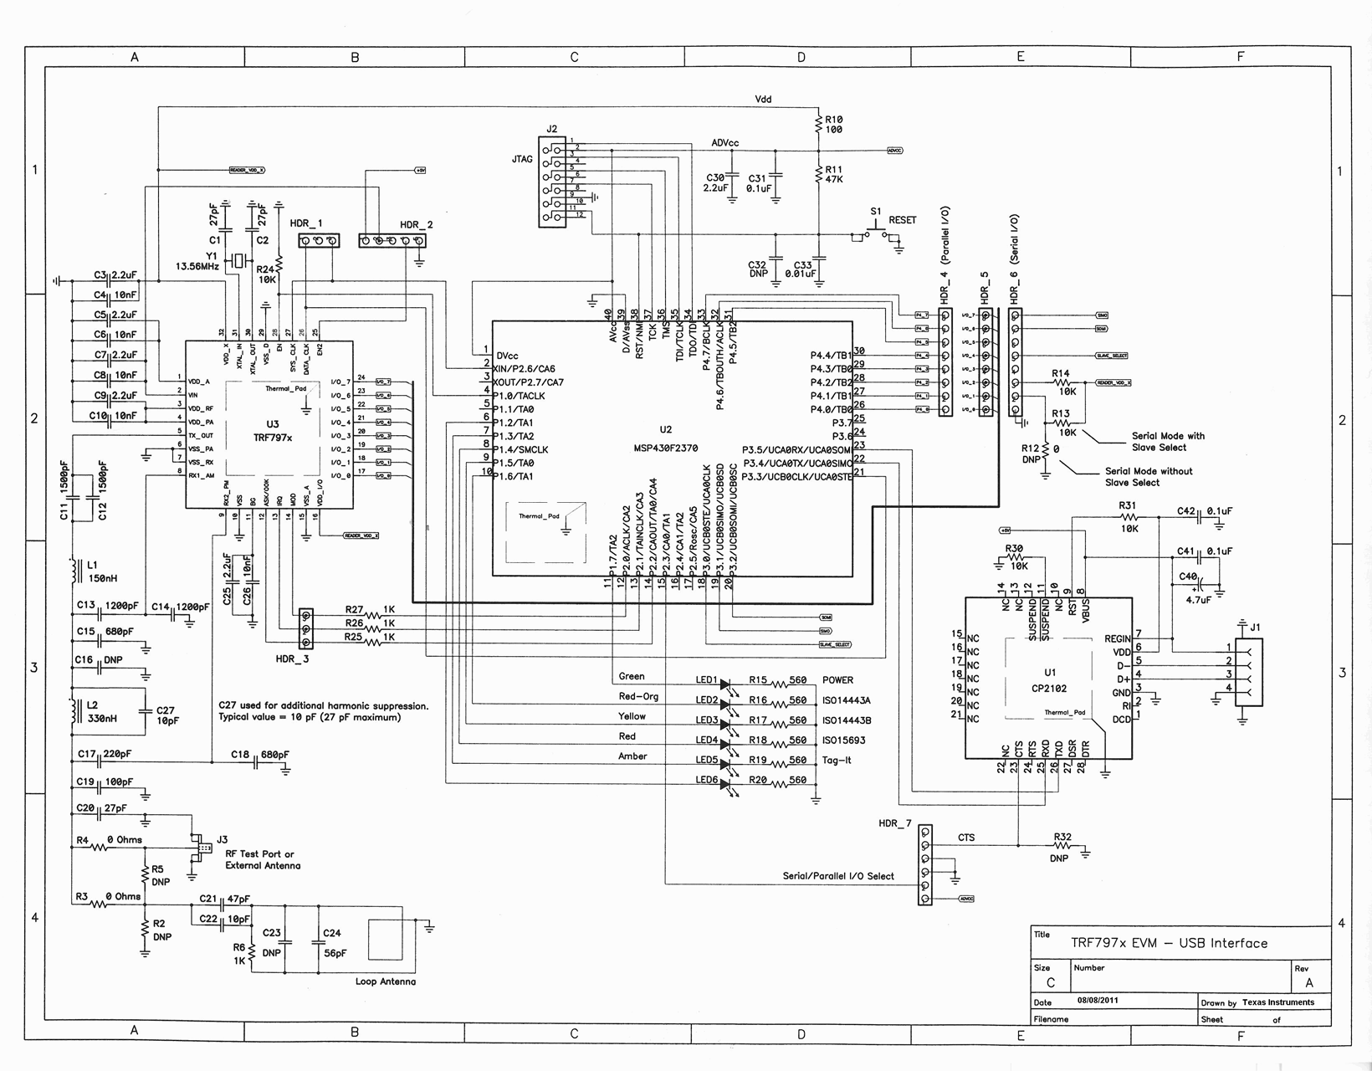
[picture p41: figure]
