Michae1Park/Batteryless_Implant/(list of files, drawings)

Other design files:
Others/UTX-2012F401.pcb
Others/UTX-2012F501.pcb
Others/UTX-2013F501COM.pcb
Others/UTX-2014S601v2.pcb
