Michae1Park/Batteryless_Implant/Others/implant6.brd

## EAGLE design Others/implant6.brd (2017-07-27)

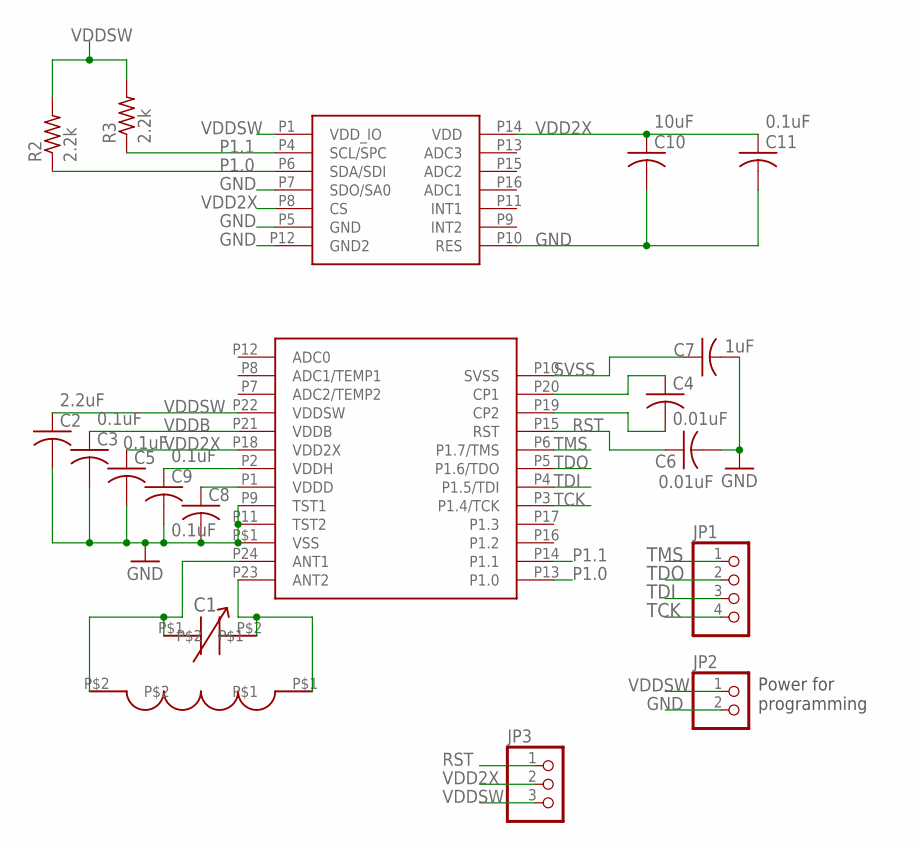
[picture p42: schematic implant6.sch]

Parts:
C2: 2.2uF; C0805
C3, C5, C8, C9, C11: 0.1uF; C0805
C4, C6: 0.01uF; C0805
C7: 1uF; C0805
C10: 10uF; C0805
JP1: PINHD-1X4; 1X04
JP2: PINHD-1X2; 1X02
JP3: PINHD-1X3; 1X03
R2, R3: 2.2k; R0805
U$1: RF430FRL152H; VQFN
U$2: COILCOIL3; COIL3
U$3: VAR_CAP
U$4: LIS3DH; LGA-16

Connections:
GND: C2.2, C3.2, C5.2, C6.2, C7.2, C8.2, C9.2, C10.2, C11.2, JP2.2, U$1.P9 (TST1), U$1.P11 (TST2), U$1.P$1 (VSS), U$4.P5 (GND), U$4.P7 (SDO/SA0), U$4.P10 (RES), U$4.P12 (GND2)
unnamed: C9.1, U$1.P2 (VDDH)
unnamed: C8.1, U$1.P1 (VDDD)
unnamed: U$1.P23 (ANT2), U$2.P$1, U$3.P$2
unnamed: C4.1, U$1.P20 (CP1)
unnamed: C4.2, U$1.P19 (CP2)
unnamed: U$1.P24 (ANT1), U$2.P$2, U$3.P$1
P1.0: R2.1, U$1.P13 (P1.0), U$4.P6 (SDA/SDI)
P1.1: R3.1, U$1.P14 (P1.1), U$4.P4 (SCL/SPC)
RST: C6.1, JP3.1, U$1.P15 (RST)
SVSS: C7.1, U$1.P10 (SVSS)
TCK: JP1.4, U$1.P3 (P1.4/TCK)
TDI: JP1.3, U$1.P4 (P1.5/TDI)
TDO: JP1.2, U$1.P5 (P1.6/TDO)
TMS: JP1.1, U$1.P6 (P1.7/TMS)
VDD2X: C5.1, C10.1, C11.1, JP3.2, U$1.P18 (VDD2X), U$4.P8 (CS), U$4.P14 (VDD)
VDDB: C3.1, U$1.P21 (VDDB)
VDDSW: C2.1, JP2.1, JP3.3, R2.2, R3.2, U$1.P22 (VDDSW), U$4.P1 (VDD_IO)

Notes on the sheet:
Power for programming

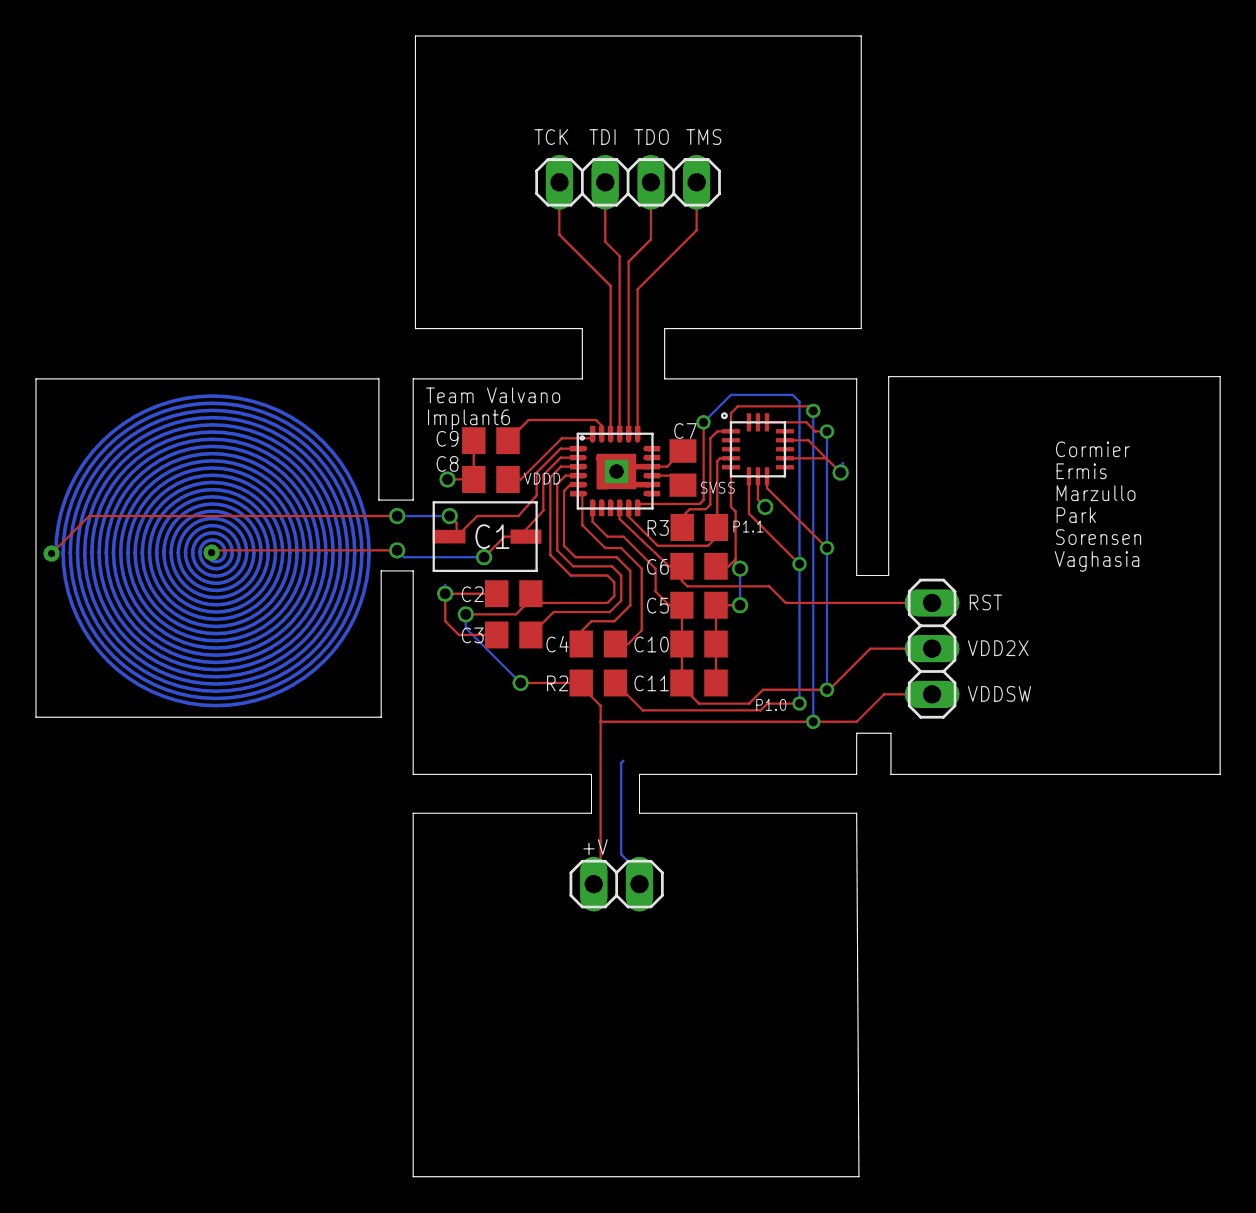
[picture p43: board implant6.brd from above]

Board: 2 copper layers, 65.8 x 63.4 mm, 19 parts (1 on the bottom side), 18 nets.
