Michae1Park/Batteryless_Implant/(commit log)

2016-06-23 migrating repo from bitbucket
    [LM TRF7970A EVM (Rev A) (2011) (-003 with U5 DNI).XLS, UTX-2012F401.pcb, UTX-2012F501.pcb, UTX-2013F501COM.pcb, UTX-2013F501COM.sch, UTX-2014S601v2.pcb, UTX-2014S601v2.sch]
2016-07-01 Added error message to InitSerial for Linux version
    [TRF7970AEVM.cpp]
2016-08-27 I2c master and slave - implant and accelerometer
2016-08-29 Fix I2C communication
2016-08-30 test code for I2C tm4c123 as a slave - Working!
2017-07-27 Add files via upload
    boards
    [implant6.brd, implant6.sch, implant7.brd, implant7.sch, implant8.brd, implant8.sch, implant9.brd, implant9.sch]
